bryanyuchen/LAB_2/Lab 2 graphics/photo of robot 2.jpg

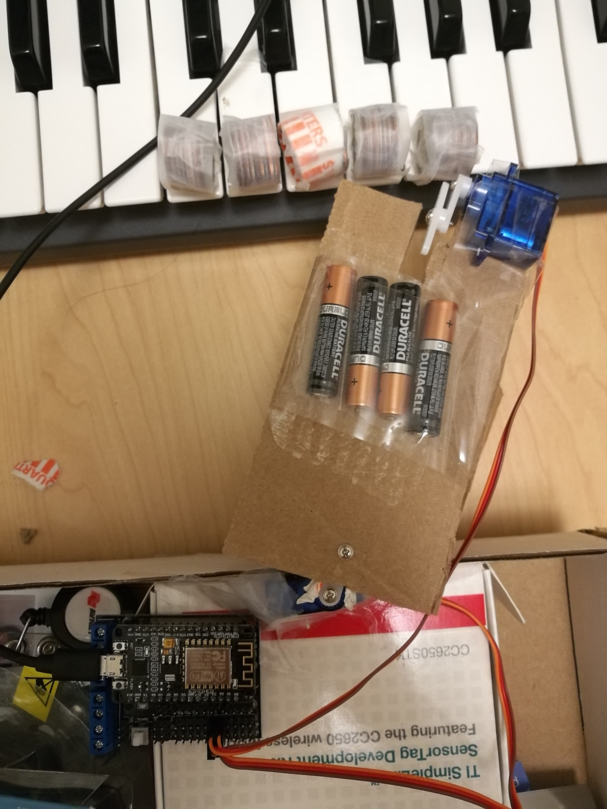
Lab 2 graphics/photo of robot 2.jpg
